swrneko/pet-recycle-stand/pictures/istockphoto-1140075616-612x612.jpg

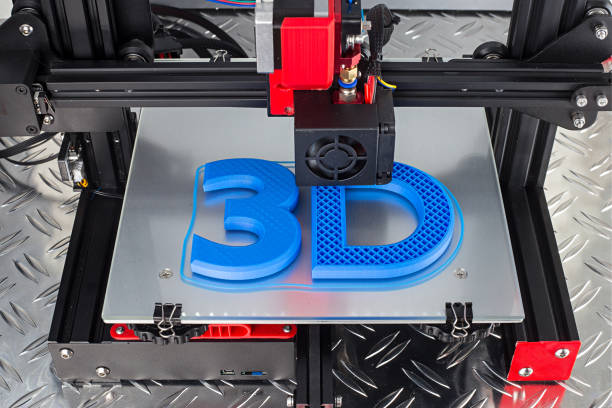
pictures/istockphoto-1140075616-612x612.jpg
