swrneko/pet-recycle-stand/pictures/1625544451_34-kartinkin-com-p-inzhener-fon-krasivie-foni-34.jpg

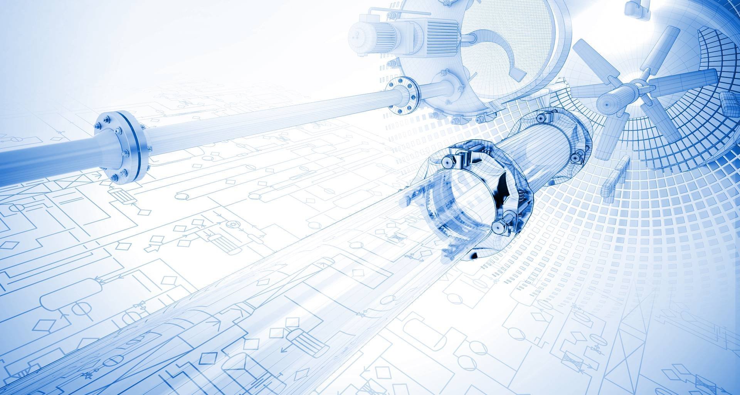
pictures/1625544451_34-kartinkin-com-p-inzhener-fon-krasivie-foni-34.jpg
