swrneko/pet-recycle-stand/README.md

В данном репозитории находятся все необходимые файлы для моего школьного проекта "переработка PET бутылок в филамент для 3д печати".
                                                                                                Автор: Егоров Александр 11 "А" класс
