swrneko/pet-recycle-stand/pictures/bigstock-Question-Mark-3993056.jpg

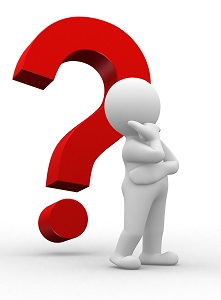
pictures/bigstock-Question-Mark-3993056.jpg
