swrneko/pet-recycle-stand/STL_files/display_module/main_body_v3.stl

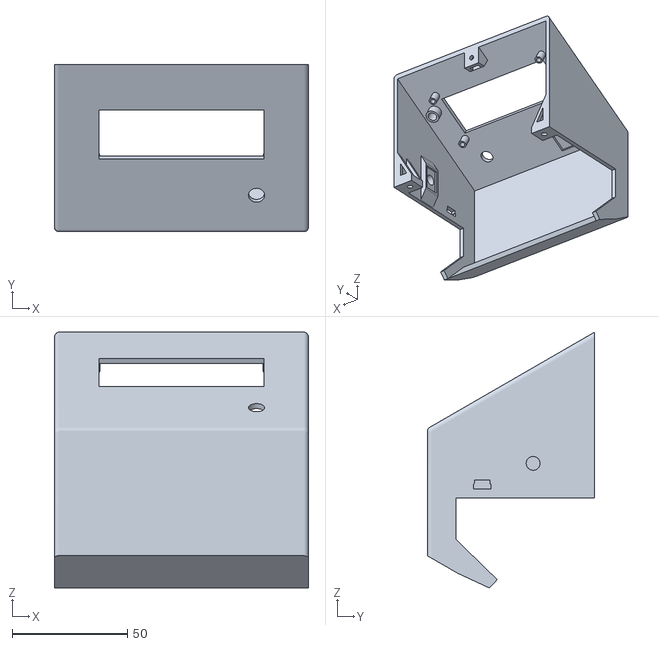
[picture p31: CAD file, 2024-01-14]
STL_files/display_module/main_body_v3.stl
110.0 x 72.5 x 110.8
