swrneko/pet-recycle-stand/STL_files/display_module/text.stl

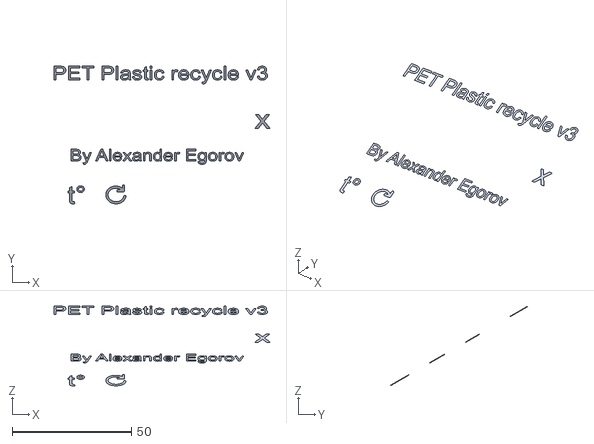
[picture p32: CAD file, 2024-01-14]
STL_files/display_module/text.stl
90.6 x 57.8 x 33.5
