swrneko/pet-recycle-stand/STL_files/reductor_module/right wall.stl

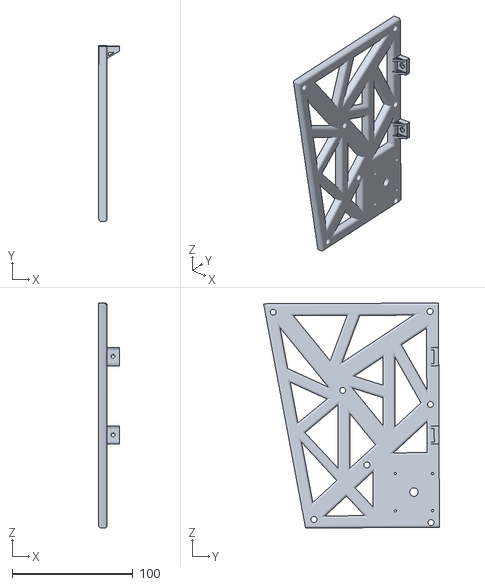
[picture p33: CAD file, 2024-01-14]
STL_files/reductor_module/right wall.stl
17.0 x 145.8 x 186.5
