swrneko/pet-recycle-stand/STL_files/reductor_module/right big spacer.stl

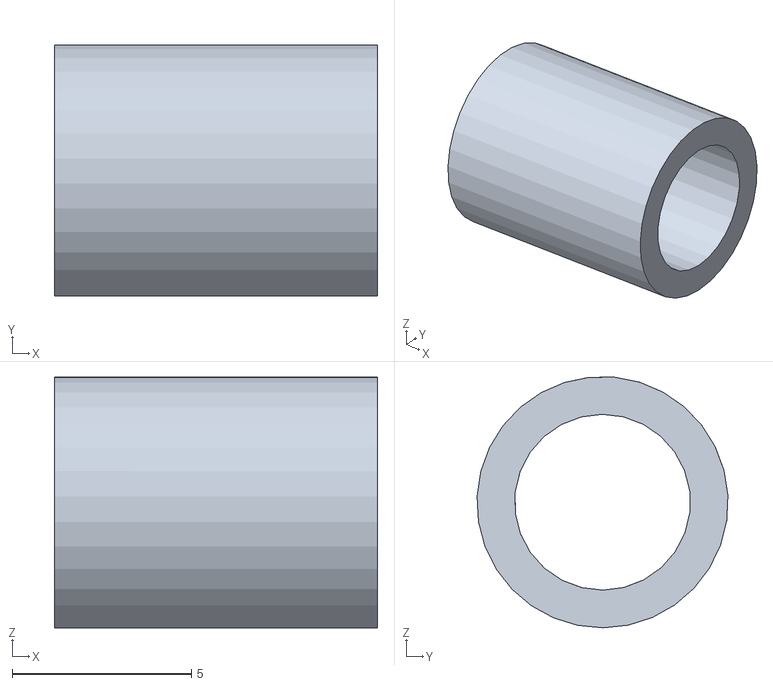
[picture p34: CAD file, 2024-01-14]
STL_files/reductor_module/right big spacer.stl
9.00 x 6.99 x 6.98
