swrneko/pet-recycle-stand/STL_files/display_module/Дисплей_v3.FCStd

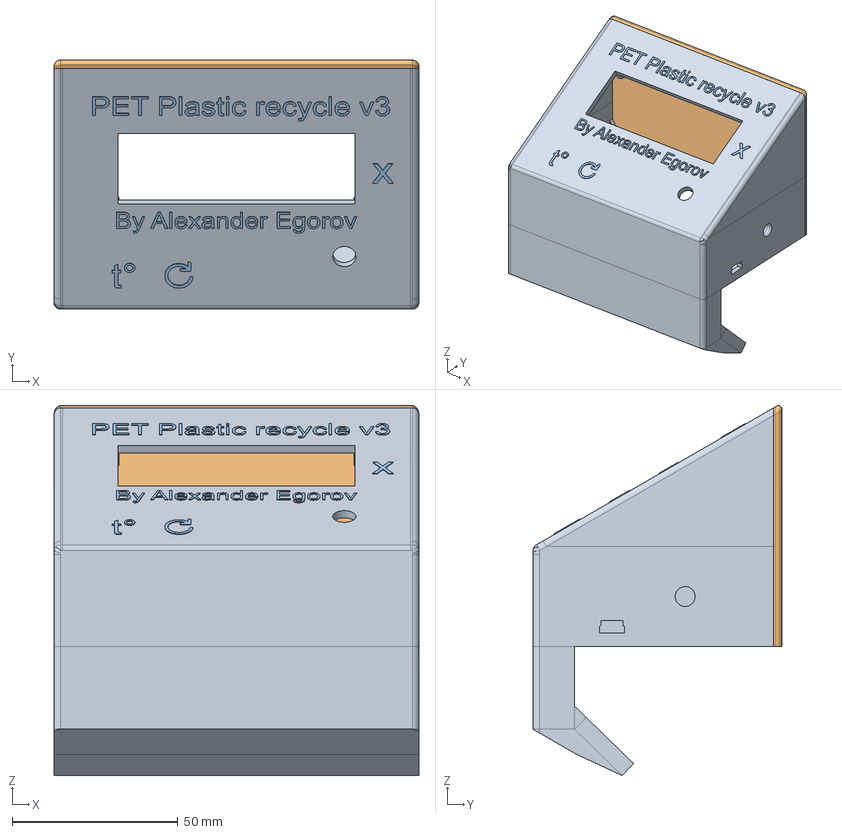
[picture p35: CAD file, 2024-01-14]
STL_files/display_module/Дисплей_v3.FCStd
110.0 x 75.0 x 111.5 mm
корпус
задняя стенка001
text
