swrneko/pet-recycle-stand/STL_files/reductor_module/adapter gear.stl

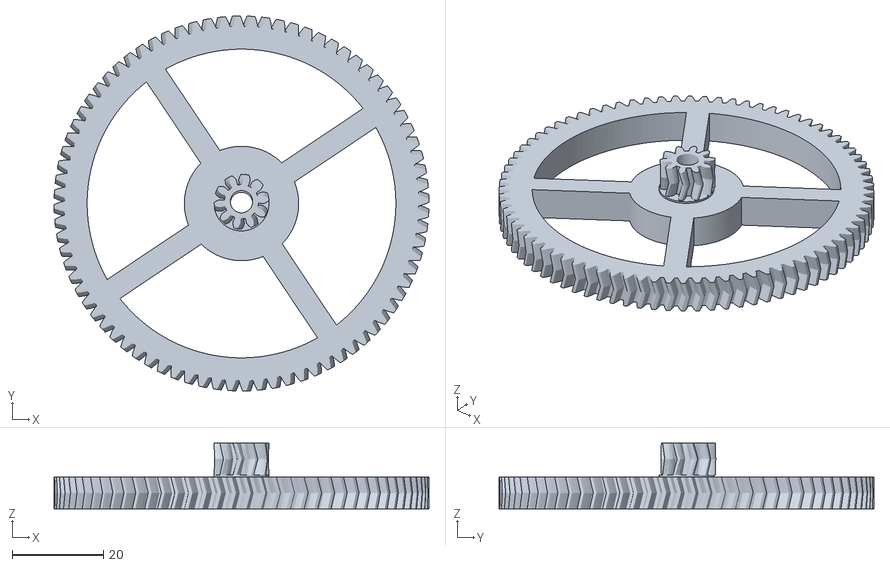
[picture p36: CAD file, 2024-01-14]
STL_files/reductor_module/adapter gear.stl
82.0 x 82.0 x 14.4
