swrneko/pet-recycle-stand/STL_files/display_module/Дисплей.FCStd

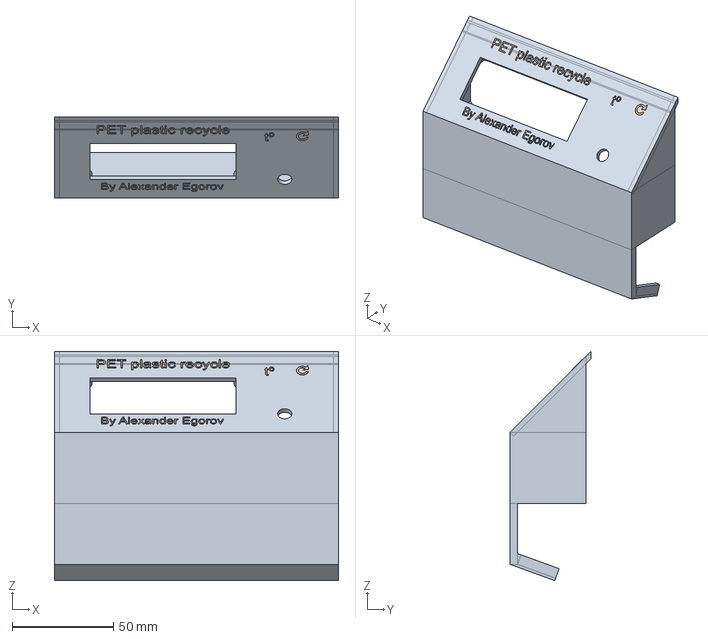
[picture p37: CAD file, 2024-01-14]
STL_files/display_module/Дисплей.FCStd
140.0 x 40.0 x 113.0 mm
основной корпус
text
