swrneko/pet-recycle-stand/STL_files/reductor_module/large gear base.stl

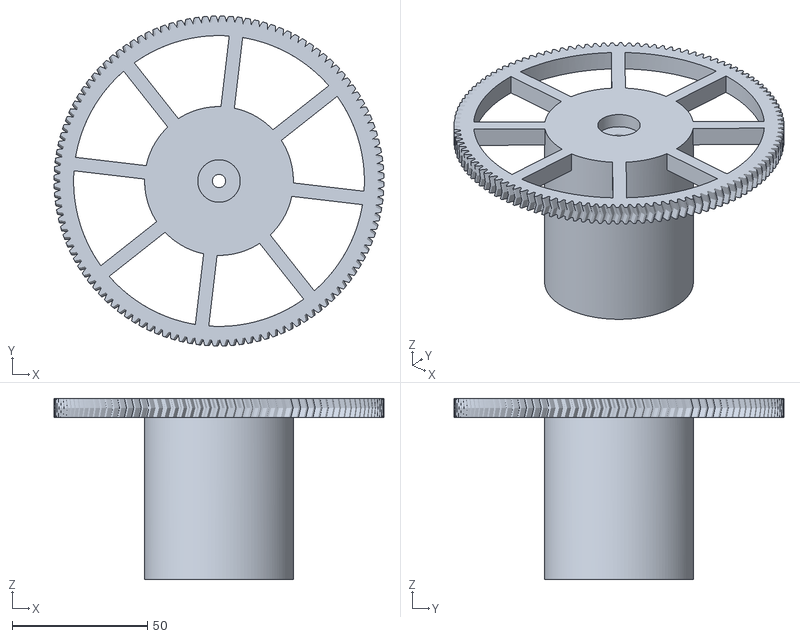
[picture p38: CAD file, 2024-01-14]
STL_files/reductor_module/large gear base.stl
122.0 x 122.0 x 67.0
