swrneko/pet-recycle-stand/STL_files/display_module/back.stl

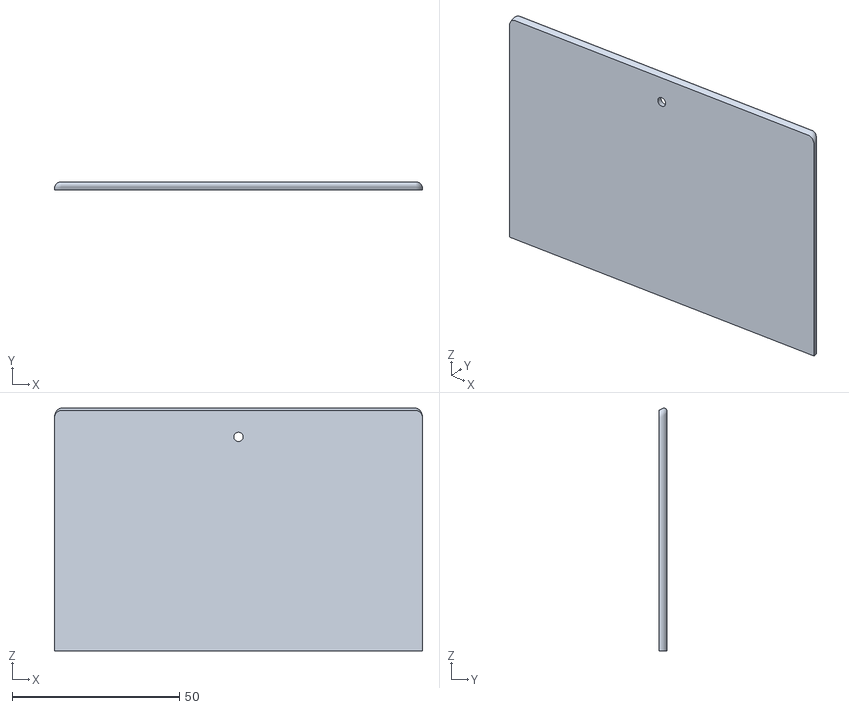
[picture p39: CAD file, 2024-01-14]
STL_files/display_module/back.stl
110.0 x 2.50 x 72.6
