swrneko/pet-recycle-stand/STL_files/reductor_module/right small spacer.stl

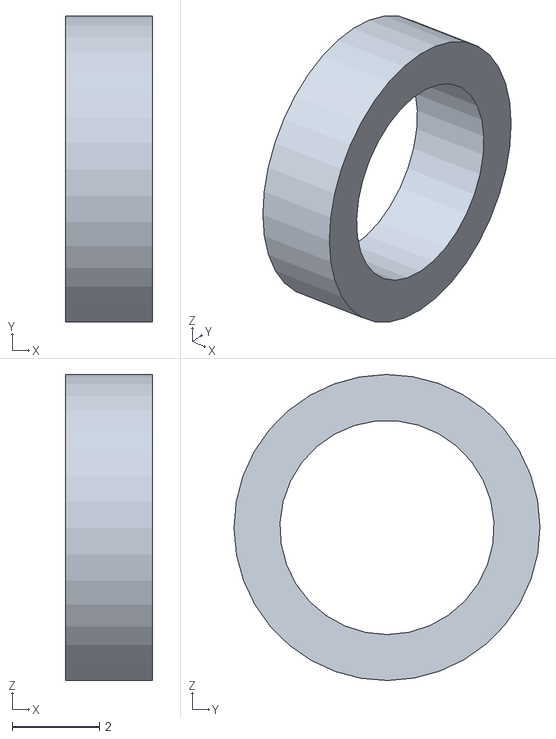
[picture p40: CAD file, 2024-01-14]
STL_files/reductor_module/right small spacer.stl
2.00 x 7.00 x 7.00
