swrneko/pet-recycle-stand/STL_files/reductor_module/spacer.stl

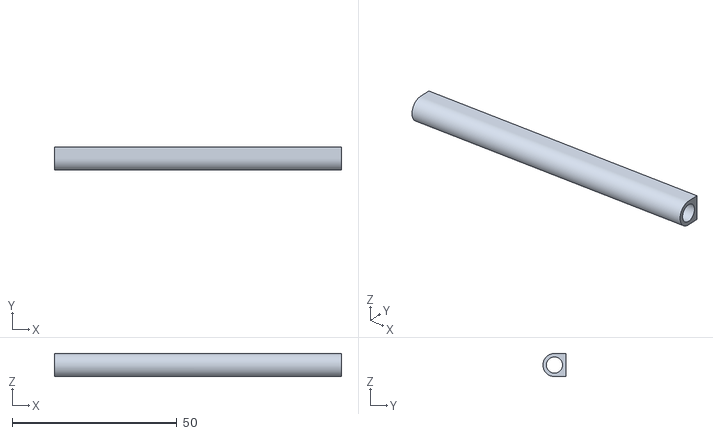
[picture p41: CAD file, 2024-01-14]
STL_files/reductor_module/spacer.stl
87.0 x 7.02 x 7.02
