swrneko/pet-recycle-stand/STL_files/reductor_module/big gear cover.stl

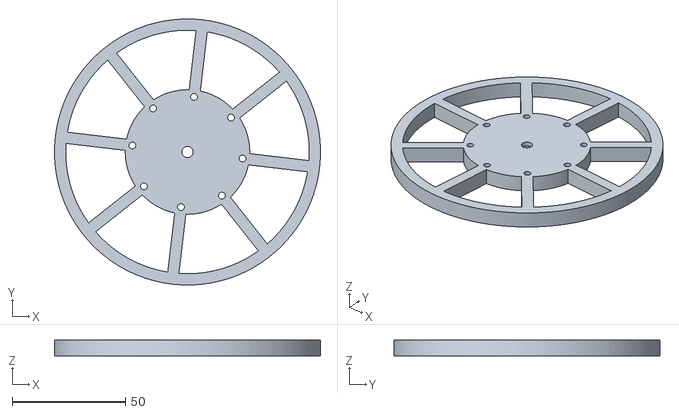
[picture p42: CAD file, 2024-01-14]
STL_files/reductor_module/big gear cover.stl
117.5 x 117.5 x 7.00
