swrneko/pet-recycle-stand/STL_files/reductor_module/small gear.stl

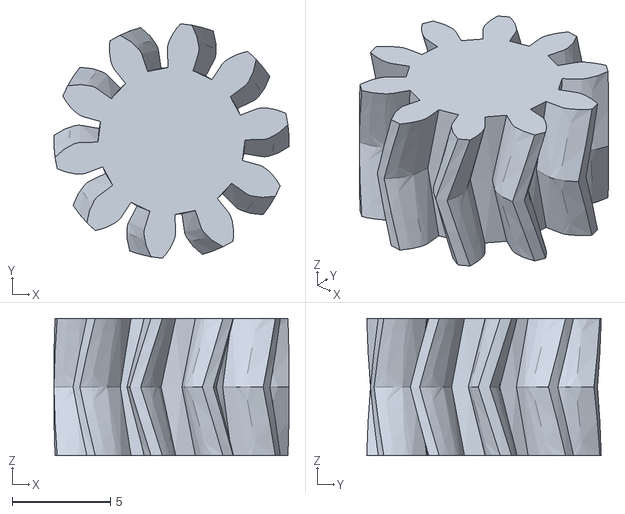
[picture p43: CAD file, 2024-01-14]
STL_files/reductor_module/small gear.stl
12.0 x 12.0 x 7.00
