swrneko/pet-recycle-stand/STL_files/reductor_module/left spacer.stl

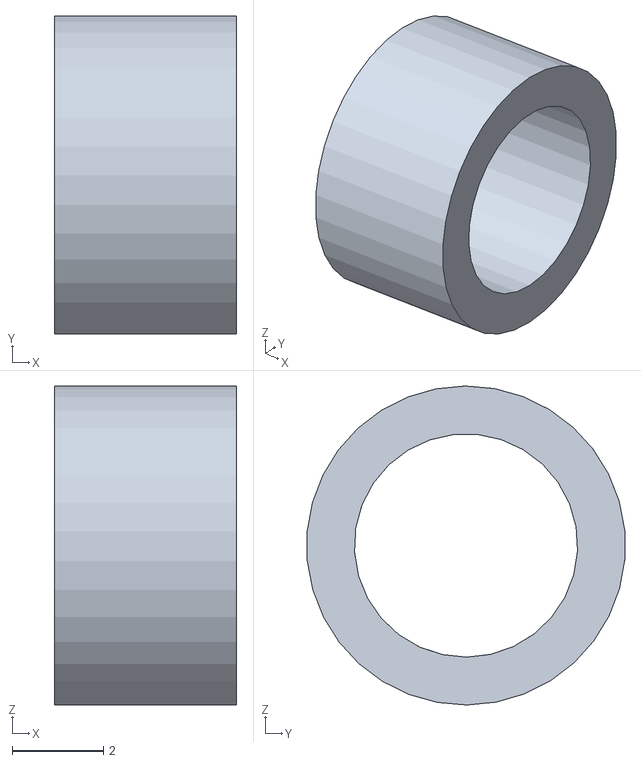
[picture p44: CAD file, 2024-01-14]
STL_files/reductor_module/left spacer.stl
4.00 x 6.97 x 7.00
