swrneko/pet-recycle-stand/STL_files/display_module/Дисплей_v2.FCStd

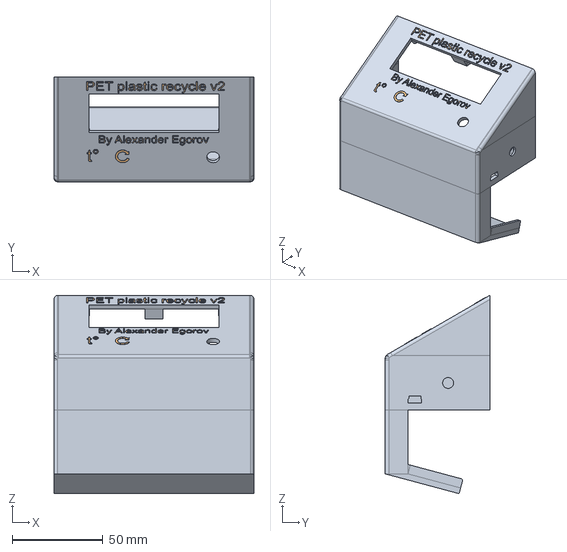
[picture p45: CAD file, 2024-01-14, an earlier design]
STL_files/display_module/Дисплей_v2.FCStd
110.0 x 57.5 x 109.1 mm
корпус
Text
