swrneko/pet-recycle-stand/(list of files, cad)

Other CAD files:
STL_files/reductor_module/left wall.stl
