swrneko/pet-recycle-stand/SCHEME/main_scheme.kicad_sch

## KiCad design SCHEME/main_scheme.kicad_sch (2024-01-25)

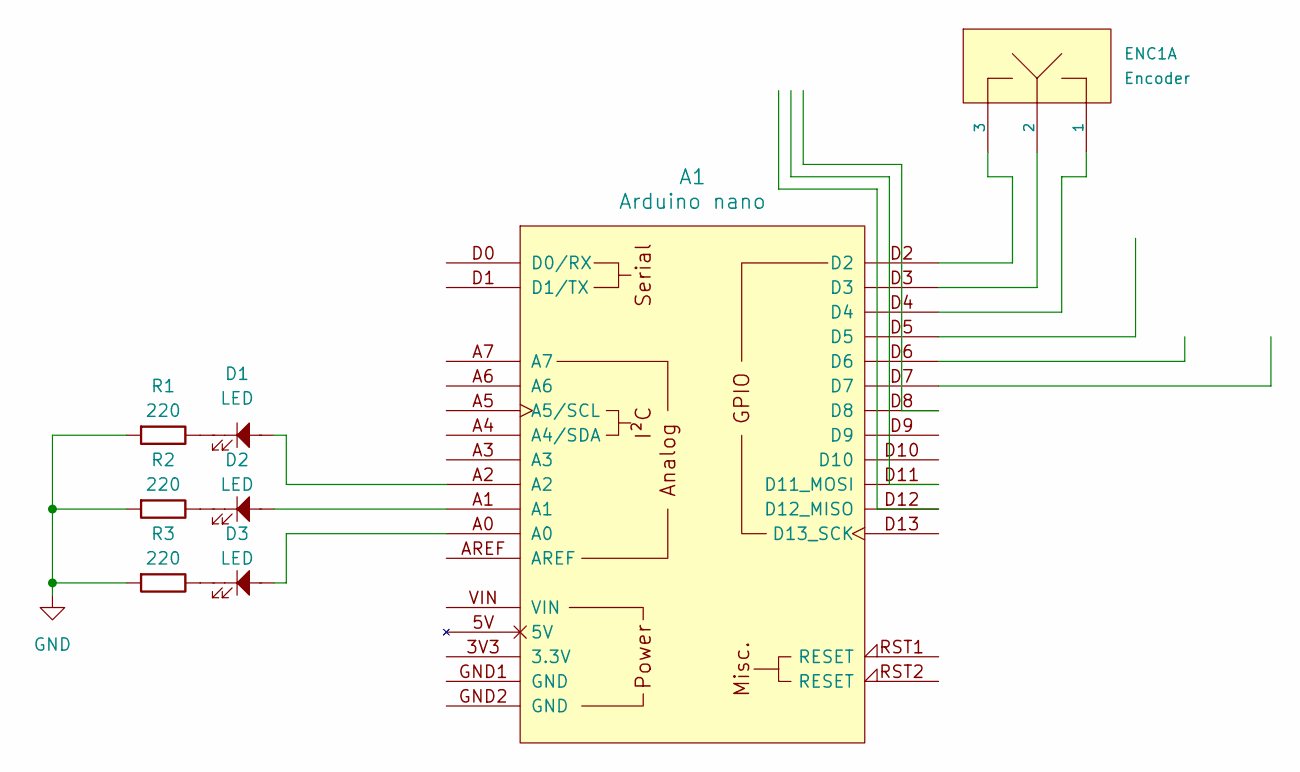
[picture p46: schematic main_scheme.kicad_sch]

Parts:
A1: Arduino nano; Arduino_Nano_Every_Socket
D1, D2, D3: LED; LED_D5.0mm
ENC1: Encoder; ENC_SPST_12mm; Part Number RE111F-41B3N-20F-20P-N
R1, R2, R3: 220; R_Axial_DIN0207_L6.3mm_D2.5mm_P10.16mm_Horizontal

Connections:
GND: R1.1, R2.1, R3.1
unnamed: A1.A0, D3.2
unnamed: A1.A1, D2.2
unnamed: A1.A2, D1.2
unnamed: A1.D2, ENC1.3
unnamed: A1.D3, ENC1.2
unnamed: A1.D4, ENC1.1
unnamed: D1.1, R1.2
unnamed: D2.1, R2.2
unnamed: D3.1, R3.2
