swrneko/pet-recycle-stand/(commit log)

2024-01-14 new files stl
    [adapter gear.stl, back.stl, big gear cover.stl, large gear base.stl, left spacer.stl, left wall.stl, main_body_v3.stl, right big spacer.stl]
2024-01-14 Очередное изменение проекта
2024-01-25 add arduino sketch
2024-01-25 add presentation
    [main_scheme.kicad_pcb, main_scheme.kicad_sch]
